j0rdanmaker/Mochi-Robot-Dog/hardware/parts/SERVO_CHECK.md

# Weight estimate and servo check

<!-- Generated by servo_check.py; do not edit by hand. Regenerate with: uv run python hardware/parts/servo_check.py -->

## Weight estimate

| Item | Mass | Source |
| --- | --- | --- |
| Servos DS3225MG x4 (shoulders) | 240 g | 60 g each, DS3225MG spec |
| Servos DS3235 x8 (hips, knees) | 480 g | 60 g each, DS3235 datasheet |
| Servo horns (metal, 25T) x12 | 72 g | est. 6 g each |
| Printed parts (Spot Micro set) | 1089 g | slicer weights from the print-status sheet (35 parts in the build) |
| Battery 2S 5200 mAh hard case | 270 g | est. 250-300 g |
| Bearings 625ZZ x12 | 58 g | 4.8 g each |
| Screws M2x8 x84 | 25 g | est. 0.3 g each |
| Screws M3x8 x92 | 64 g | est. 0.7 g each |
| Screws M3x20 x64 | 83 g | est. 1.3 g each |
| Nuts M2 x84 | 8 g | est. 0.1 g each |
| Lock nuts M3 x156 | 86 g | est. 0.55 g each |
| Buck converter SZBK07 (servo rail) | 65 g | est., with heatsinks |
| Buck converter XL4015 (logic rail) | 25 g | est. |
| ESP32-S3 CAM + camera | 15 g | est. |
| PCA9685, GY-87, PAJ7620, OLED, amp | 26 g | est. |
| HC-SR04P x2 | 18 g | est. 9 g each |
| Speaker 40 mm | 15 g | est. |
| Fuse holder, XT60 switch, mode button | 47 g | est. |
| Wiring, connectors, lever nuts, heat shrink | 120 g | est. |
| **Total** | **2807 g** | |

## Load model

- Geometry (Leika `SPOTMICRO_ESP32`): coxa 60.5 mm, femur 111.2 mm, tibia 118.5 mm. Body height 99-198 mm, default 148 mm. Full stride 176 mm.
- Servos (stall torque interpolated to the 6.3 V servo rail): shoulder DS3225MG 23.9 kg-cm; hip DS3235 32.6 kg-cm; knee DS3235 32.6 kg-cm.
- Static load only: weight split evenly over the stance feet, torque = force x horizontal lever arm. Walking adds roughly 1.5-2x on top.
- Verdict per joint as a share of stall: OK <= 33%, marginal <= 50%, above that too high.

## Joint torques

| Case | Foot force | Shoulder (DS3225MG) | Hip (DS3235) | Knee (DS3235) |
| --- | --- | --- | --- | --- |
| Standing, 4 feet, default height | 6.9 N | 4.2 kg-cm (18%) OK | 0.0 kg-cm (0%) OK | 6.1 kg-cm (19%) OK |
| Standing, 4 feet, lowest crouch | 6.9 N | 4.2 kg-cm (18%) OK | 0.0 kg-cm (0%) OK | 7.3 kg-cm (22%) OK |
| Crawl gait, 3 feet, default height | 9.2 N | 5.7 kg-cm (24%) OK | 0.0 kg-cm (0%) OK | 8.2 kg-cm (25%) OK |
| Trot, 2 feet, default height, foot under hip | 13.8 N | 8.5 kg-cm (36%) marginal | 0.0 kg-cm (0%) OK | 12.3 kg-cm (38%) marginal |
| Trot, 2 feet, default height, half stride | 13.8 N | 8.5 kg-cm (36%) marginal | 6.2 kg-cm (19%) OK | 14.7 kg-cm (45%) marginal |
| Trot, 2 feet, default height, full stride | 13.8 N | 8.5 kg-cm (36%) marginal | 12.3 kg-cm (38%) marginal | 15.7 kg-cm (48%) marginal |
| Trot, 2 feet, low height, half stride | 13.8 N | 8.5 kg-cm (36%) marginal | 6.2 kg-cm (19%) OK | 16.0 kg-cm (49%) marginal |

## Weight budget

For the typical walking case (trot, default height, half stride), the knee stays OK up to **2.08 kg** and marginal up to **3.11 kg** total robot weight. Current estimate: **2.81 kg**.

## Run time estimate

- Battery: 2S 5200 mAh = 38.5 Wh, 80% usable = 30.8 Wh.
- Servo current: idle 5 mA + (share of stall torque) x stall current; stall at the rail: DS3225MG 2.19 A, DS3235 2.14 A.
- Logic rail: 2.0 W (est.) through the XL4015 at 85%; servo rail through the SZBK07 at 90%.
- Walking: static load x1.5 for dynamics; swinging legs at 10% of stall.

| Mode | Servo rail | Battery draw | Run time |
| --- | --- | --- | --- |
| Resting (lying down, servos powered, no load) | 0.06 A (0.4 W) | 2.8 W | 11.1 h |
| Standing still, default height | 3.23 A (20.3 W) | 25.0 W | 74 min |
| Trot, default height, half stride (x1.5 dynamics) | 7.15 A (45.1 W) | 52.4 W | 35 min |

Treat these as rough: real servo draw depends on gait speed, terrain, and how hard the servos fight each other. Measure with a USB/XT60 power meter once built.
