j0rdanmaker/Mochi-Robot-Dog/hardware/wiring/output/power.bom.tsv

Id | Description | Qty | Unit | Designators
1 | Cable, 1 x 14 AWG | 0 | m | W_BATT_F1, W_BATT_PDNEG, W_F1_SW1, W_PDNEG_PS1IN, W_PDPOS_PS1IN, W_PS1_U3GND, W_PS1_U3POS, W_SW1_PDPOS
2 | Cable, 1 x 22 AWG | 0 | m | W_PDNEG_PS2IN, W_PDPOS_PS2IN, W_PDPOS_R1, W_PS2_SW2GND, W_PS2_SW2POS, W_PS2_U1GND, W_PS2_U1POS, W_PS2_U9GND, W_PS2_U9POS, W_R1_VSENSE, W_R2_PDNEG, W_VSENSE_R2, W_VSENSE_U1
3 | Connector, 100 kOhm through-hole resistor (sense divider, battery side), 2 pins | 1 |  | R1
4 | Connector, 16/19 mm momentary push button, 5 V LED ring, 2 pins | 1 |  | SW2
5 | Connector, 2S LiPo hard case, 5200-6200 mAh, XT60 male (7.4-8.4 V), 2 pins | 1 |  | BT1
6 | Connector, 47 kOhm through-hole resistor (sense divider, GND side), 2 pins | 1 |  | R2
7 | Connector, Freenove ESP32-S3-WROOM CAM, 3 pins | 1 |  | U1
8 | Connector, Inline ATC blade fuse holder, 12-14 AWG, 20 A fuse, 2 pins | 1 |  | F1
9 | Connector, MAX98357A I2S amp breakout, 2 pins | 1 |  | U9
10 | Connector, Main power switch, 30 A DC or better (XT60 anti-spark switch or high-current rocker), 2 pins | 1 |  | SW1
11 | Connector, PCA9685 16-ch PWM board (I2C 0x40, 0x70 all-call), 2 pins | 1 |  | U3
12 | Connector, R1/R2 divider midpoint | 1
13 | Connector, SZBK07 20 A buck converter - set to 6.3 V, screw terminals, 4 pins | 1 |  | PS1
14 | Connector, Solder splice - GND distribution (star ground point) | 1
15 | Connector, Solder splice - switched BATT+ distribution | 1
16 | Connector, XL4015 5 A buck converter (with voltmeter) - set to 5.0 V, screw terminals, 4 pins | 1 |  | PS2
