j0rdanmaker/Mochi-Robot-Dog/(list of files, cad)

Other CAD files:
hardware/mechanical/spotmicro-full.3mf
firmware/leika/app/static/URDF/femur.stl
firmware/leika/hardware/printable/helper_stand/2x_stand_bottom.stl
firmware/leika/simulation/src/resources/spot_pico/meshes/rl_tibia.stl
firmware/leika/app/static/URDF/tibia.stl
firmware/leika/hardware/printable/helper_stand/2x_stand_top.stl
firmware/leika/simulation/src/resources/spot_pico/meshes/rr_tibia.stl
hardware/mechanical/Shoulder_Joint_Ball_Bearing_Pin_M3x8.stl
firmware/leika/app/static/URDF/shell.stl
firmware/leika/hardware/printable/helper_stand/4x_stand_feet.stl
firmware/leika/simulation/src/resources/spot_pico/meshes/fr_femur.stl
hardware/mechanical/Limb_Top_Shell_mod.FCStd
firmware/leika/app/static/URDF/rb shoulder.stl
firmware/leika/hardware/printable/helper_stand/2x_stand_brace.stl
firmware/leika/simulation/src/resources/spot_pico/meshes/fr_coxa.stl
hardware/mechanical/Shoulder_Joint_Servomount_extended_BB.stl
firmware/leika/app/static/URDF/frame.stl
firmware/leika/simulation/src/resources/spot_pico/meshes/rr_femur.stl
hardware/mechanical/Rear_Cover_Shell_Medium.FCStd
firmware/leika/app/static/URDF/lf shoulder.stl
firmware/leika/simulation/src/resources/spot_pico/meshes/fl_coxa.stl
hardware/mechanical/Shoulder_Joint_Servo_Cap_Extended.stl
firmware/leika/app/static/URDF/lb shoulder.stl
firmware/leika/simulation/src/resources/spot_pico/meshes/fl_tibia.stl
hardware/mechanical/Shoulder_Cover.stl
firmware/leika/app/static/URDF/rf shoulder.stl
firmware/leika/simulation/src/resources/spot_pico/meshes/fr_tibia.stl
hardware/mechanical/Rear_Cover_Plate_Medium.stl
firmware/leika/simulation/src/resources/spot_pico/meshes/rl_coxa.stl
hardware/mechanical/Limb_Top_Shell_with_BB_hole.3mf
firmware/leika/simulation/src/resources/spot_pico/meshes/rl_femur.stl
firmware/leika/simulation/src/resources/spot_pico/meshes/base_link.stl
firmware/leika/simulation/src/resources/spot_pico/meshes/rr_coxa.stl
firmware/leika/simulation/src/resources/spot_pico/meshes/fl_femur.stl
firmware/leika/app/static/URDF/femur.obj
firmware/leika/app/static/URDF/frame.obj
firmware/leika/app/static/URDF/lb shoulder.obj
firmware/leika/app/static/URDF/lf shoulder.obj
firmware/leika/app/static/URDF/rb shoulder.obj
firmware/leika/app/static/URDF/rf shoulder.obj
firmware/leika/app/static/URDF/shell.obj
firmware/leika/app/static/URDF/tibia.obj
hardware/mechanical/Limb_Top_Shell_with_BB_hole.stl
hardware/mechanical/Rear_Cover_Shell_Medium.stl
