j0rdanmaker/Mochi-Robot-Dog/firmware/leika/hardware/printable/helper_stand/readme.md

# Stand files

- `2x_stand_top.stl` is from "stronger microspot stand top" by stefi01 on [Thingiverse](https://www.thingiverse.com/thing:4814187)

- `2x_stand_bottom.stl`, `2x_stand_brace.stl`, `4x_stand_feet.stl` are derived from [Nova-SM2](https://github.com/cguweb-com/Arduino-Projects/tree/main/Nova-SM2/STL%20Files)
