j0rdanmaker/Mochi-Robot-Dog/hardware/PRINT_CHECKLIST.md

# Print checklist

<!-- Generated from print_status.csv (a Google Sheets export) by print_checklist.py; do not edit by hand. Regenerate with: uv run python hardware/mechanical/print_checklist.py. Sheet: https://docs.google.com/spreadsheets/d/1-Wo08JJC0JB-biMSTE-VE9PVILEnY6z2KyEfmW9u-KA/edit -->

**22 / 35 parts done** &mdash; **727 g / 1089 g** printed.

## To print

- [ ] [Shoulder Joint Servomount](mechanical/Shoulder_Joint_Servomount_extended_BB.stl): printed: unknown, 48 g
- [ ] Shoulder Joint Servohorn Cap: printed: unknown, 28 g
- [ ] [Shoulder Joint Ball Bearing Pin](mechanical/Shoulder_Joint_Ball_Bearing_Pin_M3x8.stl): printed: unknown, 4 g
- [ ] Outer Shoulder: 0/2 printed, 32 g
- [ ] LiPo Mountingbracket Front: 0/1 printed, 5 g
- [ ] TTL Counterpiece: 0/1 printed, 5 g
- [ ] [Shoulder Joint Servomount](mechanical/Shoulder_Joint_Servomount_extended_BB.stl): 3/4 printed, 48 g
- [ ] [Shoulder Joint Ball Bearing Pin](mechanical/Shoulder_Joint_Ball_Bearing_Pin_M3x8.stl): 0/4 printed, 4 g
- [ ] Wrist: 0/4 printed, 104 g
- [ ] Wrist Counterpiece: 1/4 printed, 36 g
- [ ] [Shoulder Joint Ball Bearing Pin](mechanical/Shoulder_Joint_Ball_Bearing_Pin_M3x8.stl): 1/4 printed, 4 g
- [ ] Foot Tip: 0/4 printed, 24 g
- [ ] Servohorn 6 B-Star: 8/12 printed, 20 g

## Done

- [x] Inner Shoulder: 2/2 printed, 32 g
- [x] Chassis Side: 2/2 printed, 22 g
- [x] Top Shoulder: 2/2 printed, 20 g
- [x] Bottom Shoulder: 2/2 printed, 12 g
- [x] LiPo Mountingbracket Middle: 1/1 printed, 3 g
- [x] LiPo Mountingbracket Rear: 1/1 printed, 7 g
- [x] Circuitry Mountingplate for XL4016: 1/1 printed, 56 g
- [x] Shoulder Joint Servohorn Cap: 4/4 printed, 28 g
- [x] [Limb Top Shell](mechanical/Limb_Top_Shell_with_BB_hole.stl): 4/4 printed, 92 g
- [x] Limb Bottom Shell: 4/4 printed, 100 g
- [x] Limb Ball Bearing Mount long: 4/4 printed, 20 g
- [x] Limb Servohorn Mount long: 4/4 printed, 20 g
- [x] Front Cover Optimized: 1/1 printed, 58 g
- [x] Sensormount for the ESP32-CAM: 1/1 printed, 17 g
- [x] Cameramount for the ESP32-CAM: 1/1 printed, 15 g
- [x] Cameramount Counterpiece for the ESP32-CAM: 1/1 printed, 4 g
- [x] [Rear Cover Plate](mechanical/Rear_Cover_Plate_Medium.stl): 1/1 printed, 20 g
- [x] Rear Cover for the 1.77" TFT without a SD-Card (deprecated): 1/1 printed, 53 g
- [x] Top Cover Split Front: 1/1 printed, 48 g
- [x] Top Cover Split Rear with OLED: 1/1 printed, 28 g
- [x] Bottom Cover Split Front: 1/1 printed, 46 g
- [x] Bottom Cover Split Rear: 1/1 printed, 26 g

## Not needed

- Circuitry Mountingplate for XL4016 with Extensions
- Circuitry Mountingplate for SZBK07
- Circuitry Mountingplate for SZBK07 with Extensions
- Actual Circuitry Mountingplate Template
- Simple Mountingplate Template
- Sensormount (deprecated)
- Cameramount (deprecated)
- Rear Cover Shell Longer Version
- Rear Cover Plate Template
- Rear Cover Longer Version for the 1.8" TFT with a SD-Card (deprecated)
- Rear Cover Longer Version for the 1.77" TFT without a SD-Card (deprecated)
- Rear Cover Template
- Top Cover Split Rear (deprecated)
- Top Cover Template
- Bottom Cover Template
