j0rdanmaker/Mochi-Robot-Dog/(commit log)

2026-10-01 initial repo
    [2x_stand_bottom.stl, 2x_stand_brace.stl, 2x_stand_top.stl, 4x_stand_feet.stl, Limb_Top_Shell_mod.FCStd, Limb_Top_Shell_with_BB_hole.3mf, Limb_Top_Shell_with_BB_hole.stl, Rear_Cover_Plate_Medium.stl]
2026-10-02 Updated BOM
    [bom.csv]
